OPoltti/ProyectosIoT/IoT_BombaDeInfusion/Esquema&Script/BombaDeInfusión.jpg

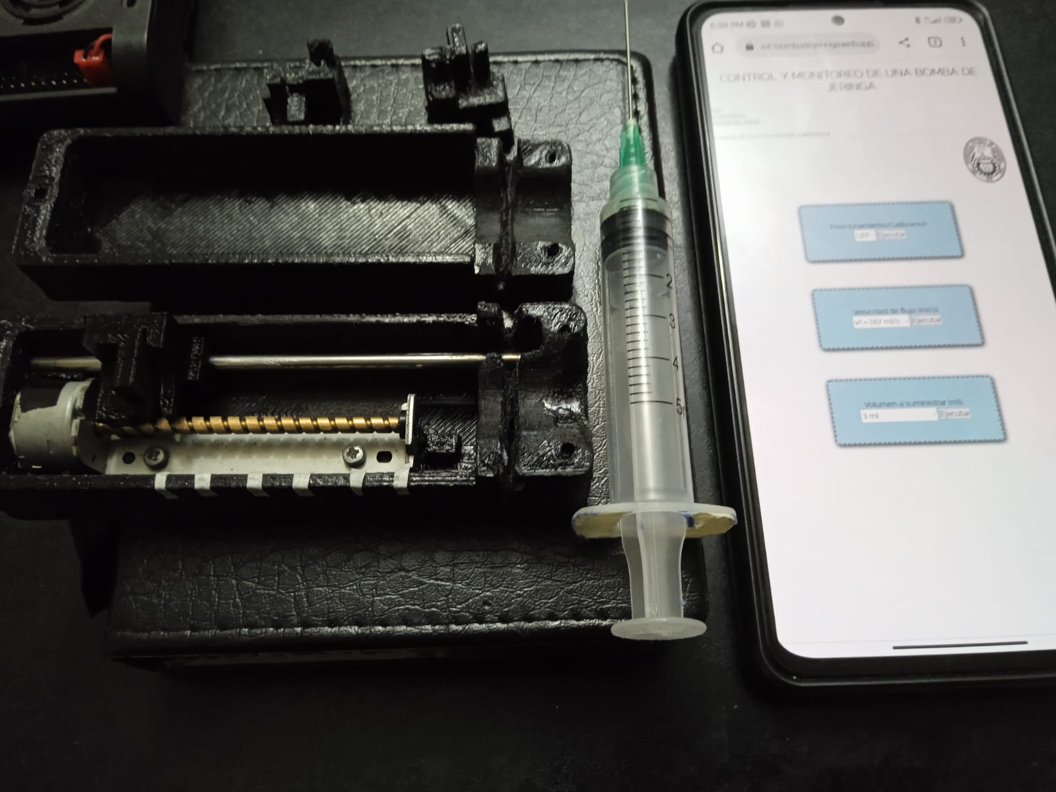
IoT_BombaDeInfusion/Esquema&Script/BombaDeInfusión.jpg
