OPoltti/ProyectosIoT/IoT_BombaDeInfusion/Esquema&Script/EsquemaCircuito.png

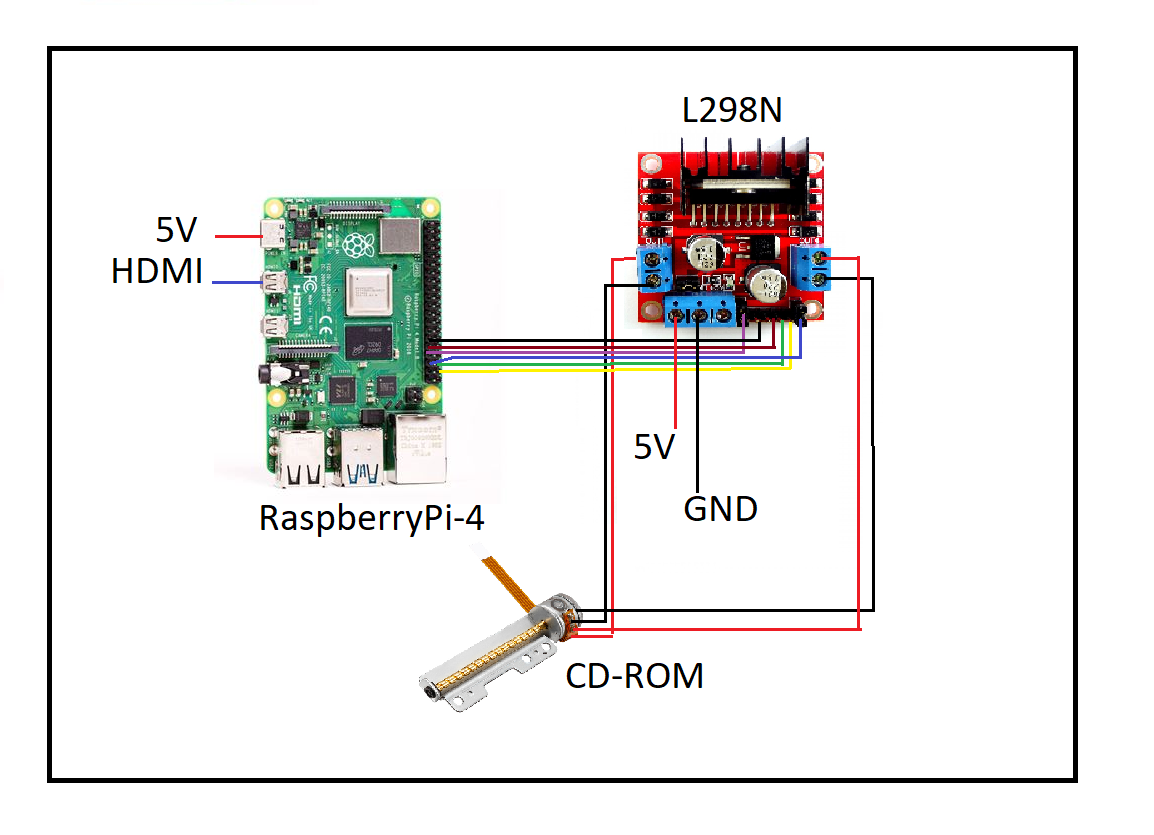
IoT_BombaDeInfusion/Esquema&Script/EsquemaCircuito.png
