OPoltti/ProyectosIoT/IoT_BombaDeInfusion/Esquema&Script/EsquemaGeneralBombaJeringa.png

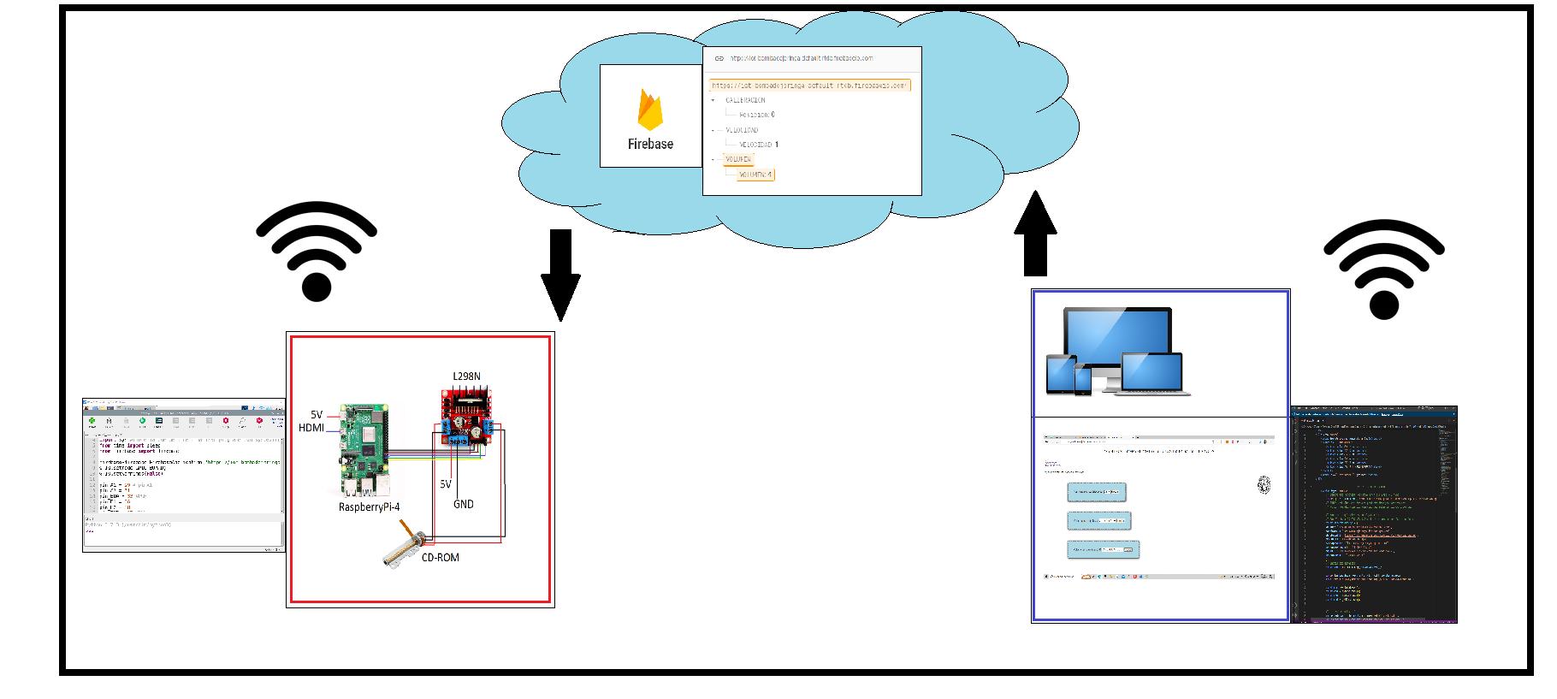
IoT_BombaDeInfusion/Esquema&Script/EsquemaGeneralBombaJeringa.png
